HarryPehkonen/xiao-ac-ssr/tools/gen_pcb.py

#!/usr/bin/env python3
"""Generate the PCB for the XIAO AC on/off (SSR) board (headless, via pcbnew).

Nets come from the *schematic* (kicad-cli netlist export), so the board can
never disagree with the design about connectivity.  Placement and routing are
explicit tables here, the same way the schematic is generated.

    python3 tools/gen_pcb.py            # write xiao-ac-ssr.kicad_pcb
    python3 tools/gen_pcb.py --dump     # print pad coordinates per net
"""
import os
import subprocess
import sys
import tempfile

import pcbnew

sys.path.insert(0, os.path.dirname(os.path.abspath(__file__)))
import gen_sch
import kicadlib as kl
import route as router

ROOT = gen_sch.ROOT
PROJECT = gen_sch.PROJECT
BOARD = os.path.join(ROOT, PROJECT + ".kicad_pcb")
SCH = os.path.join(ROOT, PROJECT + ".kicad_sch")
MM = pcbnew.FromMM


def mm(v):
    return round(float(v), 3)


# ---------------------------------------------------------------- placement --
# Board is 150 x 45 mm: four vertical packing strips plus the XIAO socket
# block on the right.  Mains lives on the left; PS1 and U2 straddle the middle
# strip because their own creepage is the barrier; logic sits on the right.
# Parts are *packed* inside their strip (row by row, no overlaps by
# construction) rather than hand-placed, so the same script keeps working when
# the part list changes.  The socket block is not packed -- see XIAO below.
#
# A strip is (x0, y0, x1): packing starts at y0 and wraps to a new row once it
# would cross x1.  Rows run downwards until the part list is exhausted, so the
# board height is sized around the packed result (see BOARD_H) instead of the
# packing being fenced in by a height chosen first.
#
# Packing starts at y = 9 rather than y = 6: the four mounting holes sit 5 mm in
# from the top corners and their courtyards reach 3.45 mm back (see MOUNTING
# below), so the first row has to clear them.  Placement never collides with a
# hole, and DRC says so.
GROUPS = [
    # mains: cord in -> fuse -> protection -> cord out, with the triac beside
    # the outlet so its load pad (Q1.2) is a short hop from J4.  The dimmer's
    # board failed to route LOAD_L when the triac sat at the far end of the
    # mains strip; here the ordering puts them together.
    ((4, 9, 50), [("J3", 0), ("F1", 0), ("MOV1", 0), ("J4", 0), ("Q1", 0)]),
    # the triac's gate resistor, in its own strip against the barrier: it is
    # mains-referenced (gate-side of the opto) so it owes logic 3 mm
    ((52, 9, 58), [("R4", 90)]),
    # parts that straddle the barrier, U2 first so its logic pins face the
    # logic-side cluster and its mains pins face the resistor strip
    ((62, 9, 96), [("U2", 180), ("PS1", 0)]),
    # logic-side resistors and the 5 V rail, right of the barrier
    ((100, 9, 126), [("R3", 90), ("D5", 0), ("C1", 0), ("C2", 0)]),
]
# J1/J2 are deliberately NOT in the strips above: the XIAO socket pair is one
# object with the *module's* geometry, placed by XIAO/place_xiao() below.  It
# used to be a fifth strip of two free 1x7 headers, which is how this board
# inherited a socket pair 6.1 mm apart for a module that needs 15.24 mm (the
# dimmer had it too -- this generator was copied from there).
MARGIN = 2.5          # mm between packed parts
# The outline is sized to the packed parts, not chosen up front.  The 14 parts
# span 33.8 mm (first row top at y = 9, deepest part at y = 42.8).  45 mm keeps
# that 9 mm at the top -- the mounting holes' courtyards need it -- and leaves
# 2.2 mm below the last row.  150 x 45 mm = 67.5 cm2, down from
# 150 x 95 mm = 142.5 cm2, which the board carried because it was built before
# the calibration existed.
#
# The mounting holes did *not* cost the board height.  Both corner holes live at
# y = 5 and y = 40, and the only parts deep enough to reach the bottom pair's
# courtyards (y 36.55 .. 43.45) are Q1/J4 in the mains strip and PS1 across the
# barrier -- all of them between x = 19 and x = 99.4, i.e. clear of both
# corners.  Moving the packing down 3 mm to clear the top pair changed nothing
# else: all 143 copper items on the new board are the pre-change routing
# translated +3.0 mm, item for item (measured), and the corner keepouts never
# bound.  Outline still 150 x 45 mm, still 11/11 routed, DRC still 0/0.
#
# The measured floor for this part list is 40 mm (11/11 routed, DRC clean); at
# 39 mm the router starts warning.  45 stays clear of it rather than spending a
# reroute defending 5 mm.
BOARD_W, BOARD_H = 150.0, 45.0

# ---------------------------------------------------------------- mounting --
# Four M3 clearance holes, one per corner, 5 mm in from both edges.  The
# footprint is a plain non-plated 3.2 mm hole: no pad, no annular ring, no net,
# so nothing is bonded and nothing sits under the screw head.  Nylon standoffs
# only -- this is a two-wire appliance with no earth conductor, so a metal
# standoff has nothing safe to be bonded to (see BOM.md).
MOUNT_FP = "MountingHole:MountingHole_3.2mm_M3"
MOUNT_INSET = 5.0             # mm from each board edge to the hole centre
MOUNT_DRILL = 3.2             # mm finished hole, M3 clearance
MOUNT_KEEPOUT = 6.0           # mm diameter of the copper-free disc around it
MOUNTING = [
    ("H1", MOUNT_INSET, MOUNT_INSET),
    ("H2", BOARD_W - MOUNT_INSET, MOUNT_INSET),
    ("H3", MOUNT_INSET, BOARD_H - MOUNT_INSET),
    ("H4", BOARD_W - MOUNT_INSET, BOARD_H - MOUNT_INSET),
]


# ------------------------------------------------------------- XIAO socket --
# The socket pair's job is to mate with a Seeed XIAO, so its geometry is the
# *module's*, not a placement decision.  Placing J1 and J2 as two free 1x7
# headers is what produced the bug this table replaces: the packer put them
# 6.1 mm apart (two footprint widths plus MARGIN), ERC was clean, DRC was
# clean, all 11 nets routed -- and the module could not physically seat.  Mating
# geometry is invisible to both checkers: every footprint is valid on its own,
# the nets are right, and nothing looks at the *pair*.  So it is stated here
# once and asserted on the finished board in check_board.py.
#
# Numbers from Seeed's own KiCad footprint for the module's DIP variant
# (github.com/Seeed-Studio/OPL_Kicad_Library, "Seeed Studio XIAO Series
# Library/XIAO-ESP32-C3-DIP.kicad_mod"): the mating part's own geometry, which
# beats a number read off a drawing, and it is where the 15.24 mm comes from
# rather than from an estimate.
#
#   through-hole pads    y = +/-7.620         -> row separation 15.240 mm
#   pad pitch            2.540 mm
#   silk body outline    x -10.414 .. 10.541  -> module length 20.955 mm
#   courtyard (F.CrtYd)  x -10.425 .. 10.550, y +/-8.900 -> 20.975 x 17.8 mm
#   USB-C shell outline  x 10.541 .. 12.051   -> overhangs the module edge by
#                        1.51 mm, at the pin-1 end.
#
# Orientation, from Seeed's front-pinout image and their symbol library, which
# agree: viewed from the component side with the USB-C connector at the top,
# the left column reads D0..D6 downwards and the right column reads 5V (VBUS),
# GND, 3V3, D10, D9, D8, D7.  D0 and VBUS are the pins *nearest the USB-C
# end*; the antenna is at the far end.  On this board the module stands with
# its rows vertical and its USB-C end towards the top edge (y = 0):
#
#   J1 = the module's left column  (D0..D6), pad column at x = row1_x
#   J2 = the module's right column (5V, GND, 3V3, D10, D9, D8, D7), one
#        row_sep to its right
#   pin 1 of BOTH rows is at the top (y = pin1_y), i.e. at the USB-C end.
#
# That is the way round the schematic reads -- in the symbol itself, now, not
# in a comment: J1.2 is named D1 (GPIO3, the SSR trigger), the second pin down
# from the USB-C end, and J2.1/J2.2 are named VBUS/GND, the first two of the
# right column.  Rotate either row by 180 deg and the board fires the wrong pin
# -- silently, because the nets are still correct.
#
# The block sits where the two loose sockets used to (x 130 on a 150 mm board);
# what changed is that it is now 19 mm wide instead of 7.5, and the module's
# envelope is what decides how much room that is.
XIAO = {
    "row1_x": 130.0,          # mm, J1's pad column (the module's left column)
    "pin1_y": 13.0,           # mm, pad 1 of each row = the USB-C end
    "pitch": 2.54,            # mm, pad pitch along a row
    "per_row": 7,             # pads per row (7 + 7 = the module's 14)
    "row_sep": 15.24,         # mm, Seeed: pads at y = +/-7.620
    "width": 17.8,            # mm across the rows (Seeed courtyard y +/-8.9)
    "usb_overhang": 2.921,    # mm, module edge beyond pin 1 (10.541 - 7.620)
    "tail": 2.794,            # mm, module edge beyond pin 7 (7.620 - -10.414)
    "connector": 1.51,        # mm, USB-C shell beyond the module edge
    "hole": 1.0,              # mm, the socket's own drill (KiCad's PinSocket)
    "pin_drill": 0.889,       # mm, Seeed drill the module's own pins into
    "rows": ("J1", "J2"),     # left column, right column
}
XIAO_GROUP = "XIAO_SOCKET"


def xiao_envelope():
    """(x0, y0, x1, y1) mm of the module body over the sockets.

    The XIAO is a single-sided module: its body sits *above* the sockets and
    its pins hang below it, so this is the area that has to stay clear of other
    footprints.  Along the rows it is the 15.24 mm pin field plus the module's
    own overhang at each end (2.921 mm at the USB end, 2.794 mm at the
    antenna end); across the rows it is the module's 17.8 mm width.
    """
    cx = XIAO["row1_x"] + XIAO["row_sep"] / 2
    y1 = XIAO["pin1_y"] + (XIAO["per_row"] - 1) * XIAO["pitch"]
    return (cx - XIAO["width"] / 2, XIAO["pin1_y"] - XIAO["usb_overhang"],
            cx + XIAO["width"] / 2, y1 + XIAO["tail"])


def xiao_clearance_to_edge():
    """How much board is left outside the module envelope, per side, in mm."""
    x0, y0, x1, y1 = xiao_envelope()
    return {"left": x0, "top": y0, "right": BOARD_W - x1, "bottom": BOARD_H - y1}


def place_all(fps):
    """Pack each group's parts into rows inside its zone.  Returns
    {ref: (x, y, rot)} for reporting."""
    out = {}
    for (x0, y0, x1), parts in GROUPS:
        cx, cy, rowh = x0, y0, 0.0
        for ref, rot in parts:
            fp = fps[ref]
            fp.SetOrientationDegrees(rot)
            bb = fp.GetBoundingBox(False, False)
            pos = fp.GetPosition()
            w = pcbnew.ToMM(bb.GetWidth())
            h = pcbnew.ToMM(bb.GetHeight())
            if cx + w > x1 and cx > x0:
                cx, cy, rowh = x0, cy + rowh + MARGIN, 0.0
            fp.SetPosition(pcbnew.VECTOR2I(
                MM(cx - (pcbnew.ToMM(bb.GetX()) - pcbnew.ToMM(pos.x))),
                MM(cy - (pcbnew.ToMM(bb.GetY()) - pcbnew.ToMM(pos.y)))))
            out[ref] = (round(cx, 2), round(cy, 2), rot)
            cx += w + MARGIN
            rowh = max(rowh, h)

    # No packed part may land in the module envelope.  check_board.py asserts
    # this on the finished board too; failing here instead means the generator
    # says which part did it and why, at the point the strip table could have
    # been wrong, rather than leaving a board that only the gate rejects.
    bx0, by0, bx1, by1 = xiao_envelope()
    for ref, fp in fps.items():
        if ref in XIAO["rows"]:
            continue
        bb = fp.GetBoundingBox(False, False)
        ex0, ey0 = pcbnew.ToMM(bb.GetX()), pcbnew.ToMM(bb.GetY())
        ex1 = ex0 + pcbnew.ToMM(bb.GetWidth())
        ey1 = ey0 + pcbnew.ToMM(bb.GetHeight())
        if ex0 < bx1 and ex1 > bx0 and ey0 < by1 and ey1 > by0:
            raise SystemExit(
                f"{ref} packs into the XIAO module envelope "
                f"({bx0:g}, {by0:g})-({bx1:g}, {by1:g}) mm: the module body "
                f"sits there.  Move its packing strip.")
    return out


def place_xiao(fps):
    """Place both rows of the socket from ONE table entry.

    The two rows are one part: their separation and their pin-1 ends come from
    XIAO above, and the packer never sees them.  Each is placed by moving its
    *pad 1* onto the wanted point -- not by setting the footprint's position,
    which would silently assume the footprint's origin is its pad 1 (true for
    this socket footprint today, and exactly the kind of assumption this whole
    change exists to stop making).
    """
    out = {}
    for i, ref in enumerate(XIAO["rows"]):
        fp = fps[ref]
        fp.SetOrientationDegrees(0)
        pad1 = next(p for p in fp.Pads() if p.GetNumber() == "1")
        want = (XIAO["row1_x"] + i * XIAO["row_sep"], XIAO["pin1_y"])
        pos, p = fp.GetPosition(), pad1.GetPosition()
        fp.SetPosition(pcbnew.VECTOR2I(pos.x + MM(want[0]) - p.x,
                                       pos.y + MM(want[1]) - p.y))
        fp.SetLocked(True)
        out[ref] = (want[0], want[1], 0)
    return out


def group_xiao(board, by_ref):
    """Join the two rows into one object, so the editor moves them together."""
    group = pcbnew.PCB_GROUP(board)
    group.SetName(XIAO_GROUP)
    board.Add(group)
    for ref in XIAO["rows"]:
        group.AddItem(by_ref[ref])
    return group


def draw_xiao_envelope(board):
    """Draw the module envelope on the courtyard layer.

    A courtyard is the layer whose meaning is "nothing else goes here", so the
    envelope is drawn as one rather than described in a comment.  It is a board
    graphic, not a footprint: check_board.py measures it against XIAO above and
    asserts no other footprint's courtyard touches it.
    """
    x0, y0, x1, y1 = xiao_envelope()
    rect = pcbnew.PCB_SHAPE(board)
    rect.SetShape(pcbnew.SHAPE_T_RECT)
    rect.SetStart(pcbnew.VECTOR2I(MM(x0), MM(y0)))
    rect.SetEnd(pcbnew.VECTOR2I(MM(x1), MM(y1)))
    rect.SetLayer(pcbnew.F_CrtYd)
    rect.SetWidth(MM(0.05))
    board.Add(rect)
    return rect


# Every net is routed on whichever layer the maze router finds; there is no
# fixed per-layer assignment (the dimmer carried a BOTTOM table that nothing
# read).

EDGE = [(0, 0), (BOARD_W, 0), (BOARD_W, BOARD_H), (0, BOARD_H), (0, 0)]


def schematic_nets():
    """{net: [(ref, pad)]} straight from the verified schematic."""
    with tempfile.TemporaryDirectory() as td:
        out = os.path.join(td, "net.net")
        subprocess.run(["kicad-cli", "sch", "export", "netlist", "--format",
                        "kicadsexpr", "-o", out, SCH], check=True,
                       capture_output=True)
        text = open(out, encoding="utf-8").read()
    tree = kl.parse(text)[0]
    nets = {}
    for net in kl.kids(kl.kid(tree, "nets"), "net"):
        name = kl.unquote(kl.kid(net, "name")[1]).lstrip("/")
        if name.startswith("unconnected-"):
            continue
        nets[name] = [(kl.unquote(kl.kid(n, "ref")[1]),
                       kl.unquote(kl.kid(n, "pin")[1]))
                      for n in kl.kids(net, "node")
                      if not kl.unquote(kl.kid(n, "ref")[1]).startswith("#")]
    return nets


def load_footprint(spec):
    """Load "Library:Name" from the system KiCad libraries.

    FootprintLoad() hands back the bare footprint *name*, so the board used to
    save as (footprint "R_Axial_..." with no library nickname.  The geometry is
    embedded either way and fab is unaffected, but with no nickname "update
    footprint from library" can never work -- and that is the whole workflow for
    swapping a part on this board (a mounting hole, an IRM-03-5, ...).
    """
    lib, name = spec.split(":")
    src = os.path.join("/usr/share/kicad/footprints", lib + ".pretty")
    fp = pcbnew.FootprintLoad(src, name)
    if fp is None:
        raise SystemExit(f"cannot load footprint {spec}")
    fp.SetFPID(pcbnew.LIB_ID(lib, name))
    return fp


def build():
    board = pcbnew.BOARD()
    board.SetFileName(BOARD)

    # --- nets, taken from the schematic -----------------------------------
    netitems = {}
    for name in schematic_nets():
        item = pcbnew.NETINFO_ITEM(board, name)
        board.Add(item)
        netitems[name] = item

    # --- footprints --------------------------------------------------------
    by_ref, fps = {}, {}
    for part in gen_sch.PARTS:
        if not part["fp"]:
            continue
        fp = load_footprint(part["fp"])
        fp.SetReference(part["ref"])
        fp.SetValue(part["val"])
        fps[part["ref"]] = fp
    placed = place_all(fps)
    placed.update(place_xiao(fps))
    for ref, fp in fps.items():
        try:
            fp.AutoPlaceFields()          # keeps reference text off the
        except AttributeError:            # neighbouring part's silk
            pass
        board.Add(fp)
        by_ref[ref] = fp
    # One object, one placement: the two socket rows are locked and grouped,
    # so nothing in the editor (or here) can drift them apart again.
    group_xiao(board, by_ref)
    if "--dump" in sys.argv or "-v" in sys.argv:
        for ref, (x, y, rot) in sorted(placed.items()):
            print(f"  {ref:<5} at ({x:>6}, {y:>6}) rot {rot}")

    # --- assign pads to their nets -----------------------------------------
    for net, members in schematic_nets().items():
        for ref, pad in members:
            fp = by_ref.get(ref)
            if fp is None:
                continue
            for p in fp.Pads():
                if p.GetNumber() == pad:
                    p.SetNet(netitems[net])

    # --- mounting holes ----------------------------------------------------
    # Placed before routing, and on the board rather than kept in a table here,
    # so the router finds them where they really are (route.py keeps a copper
    # keepout around any MountingHole footprint it sees).
    for ref, x, y in MOUNTING:
        fp = load_footprint(MOUNT_FP)
        fp.SetReference(ref)
        fp.SetValue(MOUNT_FP.split(":")[1])
        fp.SetPosition(pcbnew.VECTOR2I(MM(x), MM(y)))
        board.Add(fp)
        by_ref[ref] = fp

    # --- board outline -----------------------------------------------------
    for (x0, y0), (x1, y1) in zip(EDGE, EDGE[1:]):
        seg = pcbnew.PCB_SHAPE(board)
        seg.SetShape(pcbnew.SHAPE_T_SEGMENT)
        seg.SetStart(pcbnew.VECTOR2I(MM(x0), MM(y0)))
        seg.SetEnd(pcbnew.VECTOR2I(MM(x1), MM(y1)))
        seg.SetLayer(pcbnew.Edge_Cuts)
        seg.SetWidth(MM(0.15))
        board.Add(seg)

    # --- the XIAO's keepout, drawn on the courtyard layer -------------------
    draw_xiao_envelope(board)

    if "--no-route" not in sys.argv:
        import route as router
        router.route(board, netitems, schematic_nets())
    write_rules()
    pcbnew.SaveBoard(BOARD, board)
    return board


M = ("L_IN|L_FUSED|N_AC|LOAD_L|MOC_MT2|TRIAC_G")
RULES = f'''(version 1)
(rule "mains isolation barrier (mains vs logic, 3 mm)"
\t(constraint clearance (min 3mm))
\t(condition "(A.NetName =~ '^/?({M})$' && !(B.NetName =~ '^/?({M})$')) || (B.NetName =~ '^/?({M})$' && !(A.NetName =~ '^/?({M})$'))"))
(rule "mains track width"
\t(constraint track_width (min {router.WIDTH_MAINS:g}mm))
\t(condition "A.NetName =~ '^/?({M})$'"))
'''


def write_rules():
    """Custom DRC rules: the isolation barrier as machine-checked geometry."""
    path = os.path.join(ROOT, PROJECT + ".kicad_dru")
    open(path, "w").write(RULES)
    print(f"wrote {os.path.basename(path)} (3 mm mains clearance rule)")


def dump():
    board = pcbnew.LoadBoard(BOARD)
    print(f"{'net':<10} {'ref.pad':<10} x      y")
    for net in sorted(schematic_nets()):
        for fp in board.GetFootprints():
            for pad in fp.Pads():
                if pad.GetNetname().lstrip("/") == net:
                    p = pad.GetPosition()
                    print(f"{net:<10} {fp.GetReference() + '.' + pad.GetNumber():<10} "
                          f"{mm(pcbnew.ToMM(p.x)):<6} {mm(pcbnew.ToMM(p.y))}")


if __name__ == "__main__":
    if "--dump" in sys.argv:
        dump()
    else:
        build()
        print(f"wrote {BOARD}")
        fp_count = len(list(pcbnew.LoadBoard(BOARD).GetFootprints()))
        x0, y0, x1, y1 = xiao_envelope()
        print(f"  {fp_count} footprints, {len(schematic_nets())} nets, "
              f"board outline {BOARD_W:g} x {BOARD_H:g} mm, "
              f"{len(MOUNTING)} mounting holes")
        print(f"  XIAO socket {XIAO_GROUP}: {len(XIAO['rows'])} rows of "
              f"{XIAO['per_row']} at {XIAO['pitch']:g} mm pitch, "
              f"{XIAO['row_sep']:g} mm apart; module envelope "
              f"({x0:g}, {y0:g})-({x1:g}, {y1:g}) = "
              f"{x1 - x0:g} x {y1 - y0:g} mm, "
              f"{xiao_clearance_to_edge()['right']:g} mm to the right edge")
