HarryPehkonen/xiao-ac-ssr/(commit log)

2026-11-03 SSR on/off board for the XIAO: same family as the dimmer, zero-cross opto + snubberless triac
    Copy of the xiao-ac-dimmer toolchain with the switching element replaced:
    U2 MOC3021M (random phase) -> MOC3063M (zero-cross, 5 mA I_FT grade)
    Q1 BTA16-600B (I_GT 50 mA) -> BTA16-600SW (I_GT 10 mA, logic level)
    R3 220R -> 150R (the 5 mA part needs 7.5 mA cold)
    R4 (new) 360R gate resistor, onsemi's figure-10 value
    deleted: U1 H11AA1 zero-cross detector, R1/R2 47k legs, R5 10k pull-up,
    CS1/RS1 snubber -- no phase control, so no timing and no snubbing
    The B -> SW change is the one the ticket did not anticipate: a zero-cross opto
    only conducts inside its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
    [xiao-ac-ssr.kicad_pcb, xiao-ac-ssr.kicad_sch]
2026-11-03 kicad_pro: let KiCad fill in its project defaults, once
    Every generator run rewrote this file with KiCad's default board settings
    (3dviewports, dimension/copper/silk text and line widths). The content is
    stable after the first fill-in, so committing it stops a cosmetic dirty tree
    after every /usr/bin/python3 tools/gen_pcb.py.
2026-11-03 Board gate: the committed board must be the generated board
    Four gates was not enough. The schematic has been hash-gated since the dimmer,
    but the *board* was only DRC-gated -- and a hand-edited .kicad_pcb (a track
    moved, a pad renumbered, the mains barrier narrowed by a tenth of a millimetre)
    can be perfectly DRC-clean.
    The board file cannot be hash-compared: pcbnew stamps a fresh UUID on every
    footprint, pad, track and text it creates, and KiCad writes them back in its own
    order. What IS reproducible is the board: measured 14/14 footprints and
    143/143 tracks+vias identical between consecutive runs and against the committed
    board. So tools/check_regen.py regenerates in a throwaway copy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
2026-11-03 pcb: size the outline to the parts -- 150 x 95 -> 150 x 45 mm, 142.5 -> 67.5 cm2
    This board was built as the dimmer's sibling, so it inherited the dimmer's
    outline -- and with it the dimmer's dead band, without ever having had the
    routing failure that bought it. The 14 parts span 33.8 mm vertically
    (y 6 -> 39.8 mm), so the 95 mm board carried 55 mm of empty board below the
    last row.
    Final outline: 150 x 45 mm = 67.5 cm2 (was 150 x 95 mm = 142.5 cm2).
    6 mm above the first row, 33.8 mm of parts, 5.2 mm below the last one:
    15% spare on that side, the same rule the dimmer's 57 mm came from.
    Shrinking removes the router's spare corridors, so this is a new routing
    claim: 40, 41, 42, 43, 44 and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
    [xiao-ac-ssr.kicad_pcb]
2026-11-03 route: a cell off the grid is blocked, not an IndexError
    The same guard the dimmer was missing, and this repo shares the file. _open()
    walks a pad's opening box and its escape spoke in cell coordinates and asks the
    grid about every cell it lands on, but Grid.is_blocked() indexed the bytearray
    with whatever cell it was handed -- unlike unblock(), block() and inside(),
    which all refuse a cell that is not on the grid. A pad within the opening's
    reach of an edge therefore read past the end of the grid and raised
    IndexError: bytearray index out of range
    from inside the router, where the contract is the router's own
    "no path <ref>.<pad> -> <ref>.<pad> [diagnosis]".
    tools/tests/test_route_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
    [route.py]
2026-11-03 pcb: 4x M3 mounting holes, library nicknames, and the nickname+keepout gate
    The dimmer's a32a414 pass, applied to the SSR one generation later. Three
    changes in one regeneration pass, all of them in the generated board.
    1. Four M3 mounting holes, 5 mm inset from each corner,
    MountingHole:MountingHole_3.2mm_M3 -- non-plated, no pad, no net, excluded
    from the BOM and position files (measured on the saved board, not assumed)
    -- each with a 6 mm-diameter copper-free disc because an M3 screw head sits
    over it. route.py blocks that disc on both occupancy grids and as an _open()
    veto, inflated by half the widest track plus the half-cell diagonal.
    The board did NOT grow: the hol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
    [xiao-ac-ssr.kicad_pcb]
2026-11-03 pcb: the XIAO socket pair is one 15.24 mm object -- the defect this board inherited
    Measured before anything changed, not assumed from the sibling: J1 and J2 were
    two independent generic 1x7 sockets 6.10 mm apart (pads at x = 131.825 and
    137.925). Pitch ok, 7+7=14 pins ok, netlist right, ERC clean, DRC clean, 11/11
    routed -- and the module could not physically seat, because a XIAO needs the
    rows 15.24 mm apart. The mating interface only exists in the *pair*, and no ERC
    or DRC rule looks at a pair, so this board carries both the fix and the
    assertion.
    * gen_pcb.py: an XIAO table holding the module's geometry (row_sep 15.24 mm from
    Seeed's own OPL_Kicad_Library XIAO-ESP32-C3-DIP footprint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
    [xiao-ac-ssr.kicad_pcb]
2026-11-03 sch: J1/J2 get a symbol whose pins carry the module's names
    The dimmer's pass (xiao-ac-dimmer 5f3ee7f) applied to this board: a generic
    Conn_01x07 says Pin_2 where the board means D1/GPIO3, so the schematic's answer
    to "which pin is the trigger?" was a comment a reviewer had to trust. Each row
    now has its own symbol -- symbols/xiao-ac.kicad_sym, generated from XIAO_ROWS in
    gen_sch.py -- with the module's own pin names (D0..D6 on J1, VBUS..D7 on J2),
    pin 1 at the USB-C end on both, 2.54 mm pitch and a body as long as the module.
    Not Seeed's own C3 symbol: theirs is the SMD variant, 22 pins numbered 1..14
    continuously across the columns, while this board carries the DIP socket --
    14 holes, t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
    [xiao-ac-ssr.kicad_pcb, xiao-ac-ssr.kicad_sch]
2026-11-03 docs/tests: say why the pin-name cases sabotage a copy, not the committed file
2026-11-06 docs: DigiKey order for the SSR board, numbers read off the live pages
    13 lines for 3 boards (per-board counts x3), each DigiKey number verified on its
    product page today. Records the two BOM.md errors it corrects (triac number, D5
    value vs footprint) and the opto decision (MOC3063M-ND, onsemi, in stock).
    Five part numbers were resolved by Manual Entry rather than read off a page, so
    their price/stock cells are left blank rather than invented.
2026-11-06 docs: the DigiKey order after building it in a cart, corrections included
    13 lines built into a live cart and read back: subtotal $70.26 CAD. Two numbers in the
    first pass were wrong for the cart: R4 CFR-25JT-52-360R does not resolve (use
    CFR-25JB-52-360R / 360QBK-ND) and R3 CFR-25JB-52-150R is on backorder, which would hold
    the order (swapped to the stocked metal film MFR-25FBF52-150R / 150XBK-ND). Records the
    real DigiKey numbers the cart shows, and why the list lives here rather than in a cart:
    the cloud browser's 5-minute provider lifetime kills the session, and the cart does not
    survive it, logged in or not.
